Fox-2k/PaperClock/(commit log)

2021-10-17 Resolve "Fix clock setup"
    [paperclock.ino]
2021-10-30 Limit humidity to [0, 100] %, fix 100% display
    [paperclock.ino]
